Yiluo-pHoton/CISS-ROV2017/Photos/WechatIMG2279.jpeg

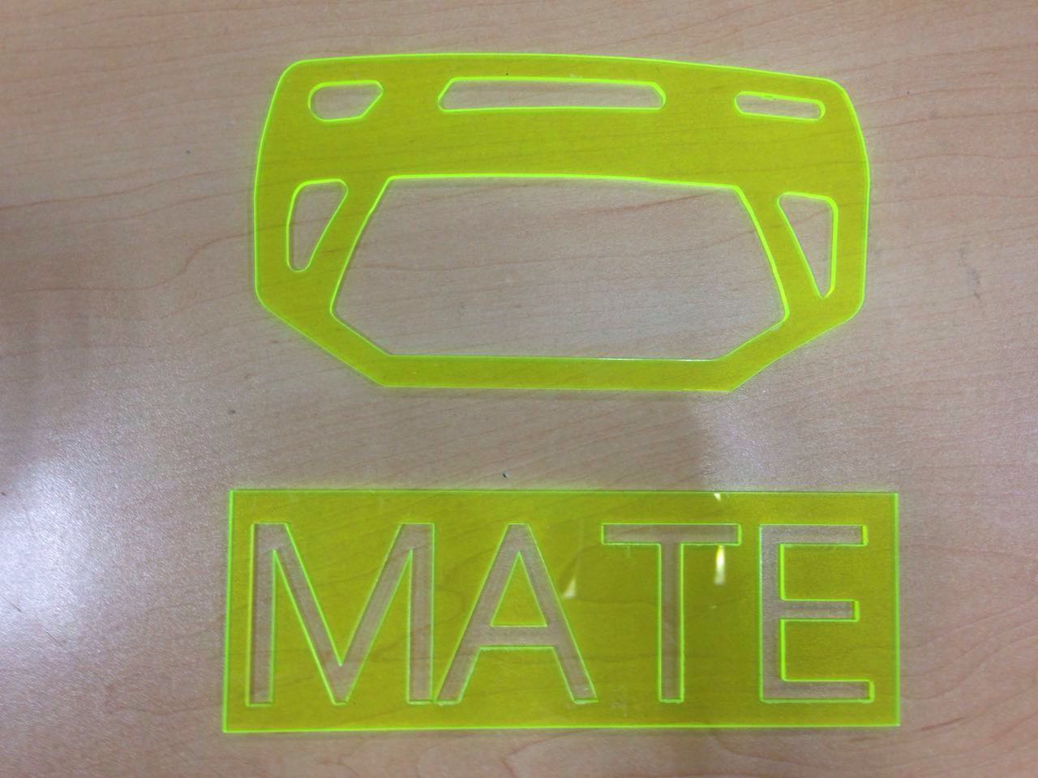
Photos/WechatIMG2279.jpeg
