Yiluo-pHoton/CISS-ROV2017/Photos/WechatIMG2266.jpeg

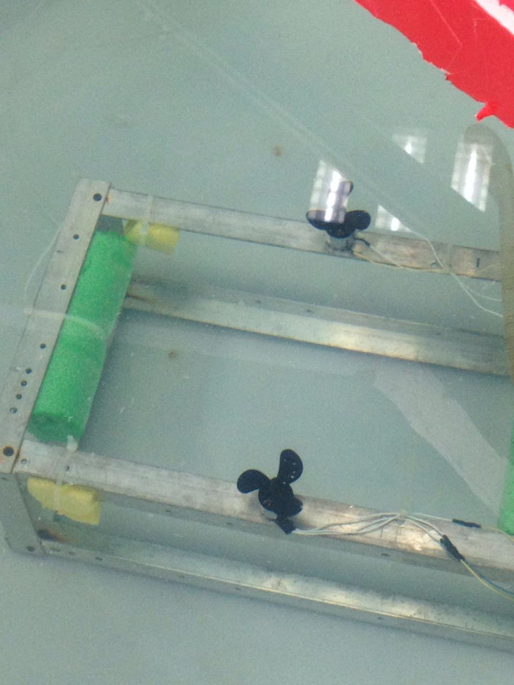
Photos/WechatIMG2266.jpeg
