Yiluo-pHoton/CISS-ROV2017/README.md

Concordia Underwater Robotics for MATE 2017
===================
All files related to the competition issued by the MATE Center are included in the ```Official File``` folder.
Communication between the mission control and the ROV is through the client.py file. However, the most updated file is on the Raspberry Pi and is not included here.

**Team Catalyst**
Danny Kong - Director
Yiluo Li – Director
Andrew Chen – Hardware Engineer, Pilot Joshua Cheng – Chief Engineer
Ryuichi Yanagi – Hardware Engineer Sam Chen – Technician
Joel Klammer – Mentor

**Acknowledgement:**
Joel Klammer
MATE Center
Concordia International School Shanghai
