Yiluo-pHoton/CISS-ROV2017/Docs/Ranger_R18_China_Concordia_Spec_003.pdf

# Catalyst

# Project Wormhole Spec Sheet

Safety features: Fuse, propeller shrouds, rounded corners on frame
Special features: Manipulator with five degrees of motion, multiple cameras, acrylic frame, joystick control, minimal wires in tether, ability to move along 4 axes of motion: forward/back, left/right, up/down, yaw, and 3 angular stabilization axes: zenith/elevation azimuthal, and roll.
Thrusters: 4 main thrusters angled at 45° and 2 up/down motors
Dimensions: 30 cm x 28cm x 25cm
Cameras: 2 front stereo, 1 front main, 1 tether
looking down, 1 on back for third-person
view

# Team Catalyst

Danny Kong - Director
Yiluo Li – Director
Andrew Chen – Hardware Engineer, Pilot Joshua Cheng – Chief Engineer
Ryuichi Yanagi – Hardware Engineer Sam Chen – Technician

Joel Klammer – Mentor

Base of Operations: Concordia International School Shanghai, Shanghai, China
