Yiluo-pHoton/CISS-ROV2017/Official Files/Controller Button Mapping.png

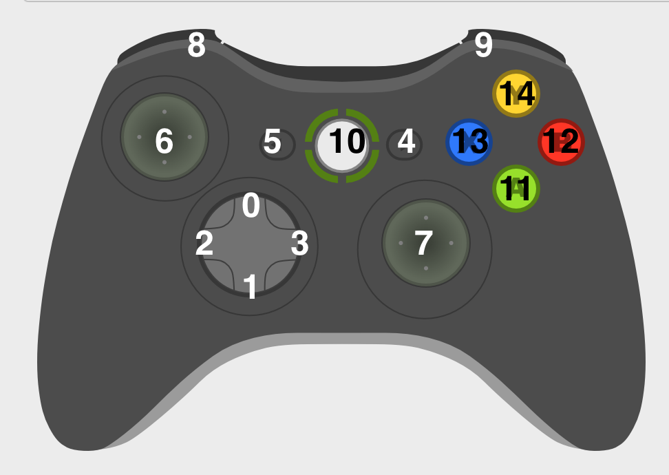
Official Files/Controller Button Mapping.png
