Yiluo-pHoton/CISS-ROV2017/Official Files/Spectrometer Info.png

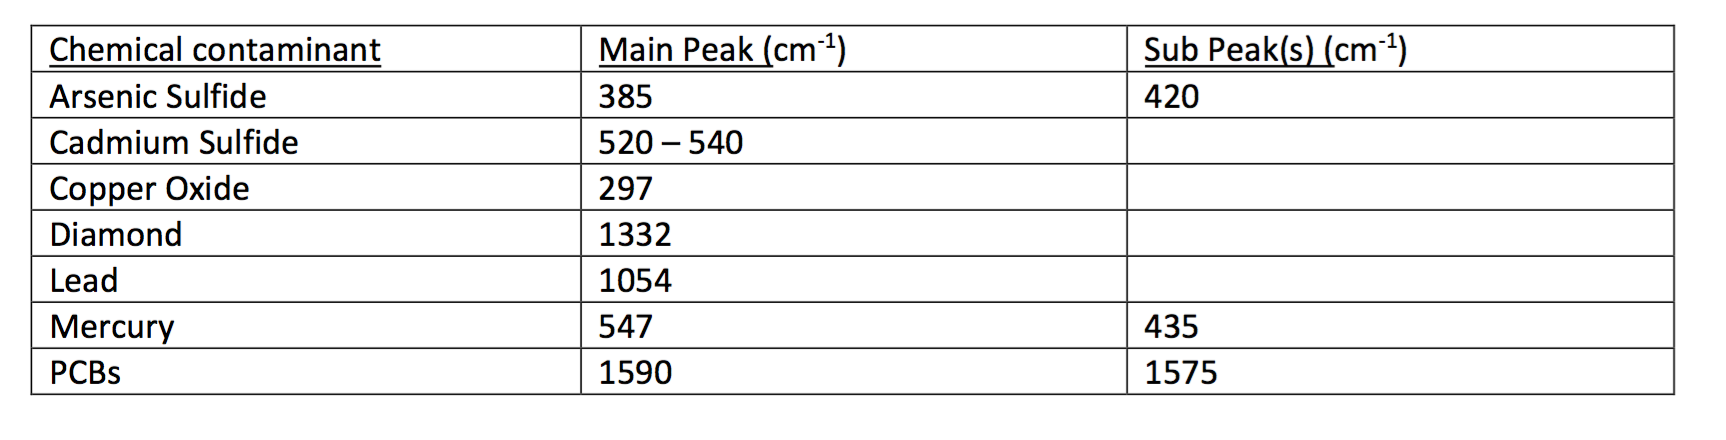
Official Files/Spectrometer Info.png
