Yiluo-pHoton/CISS-ROV2017/Photos/WechatIMG2262.jpeg

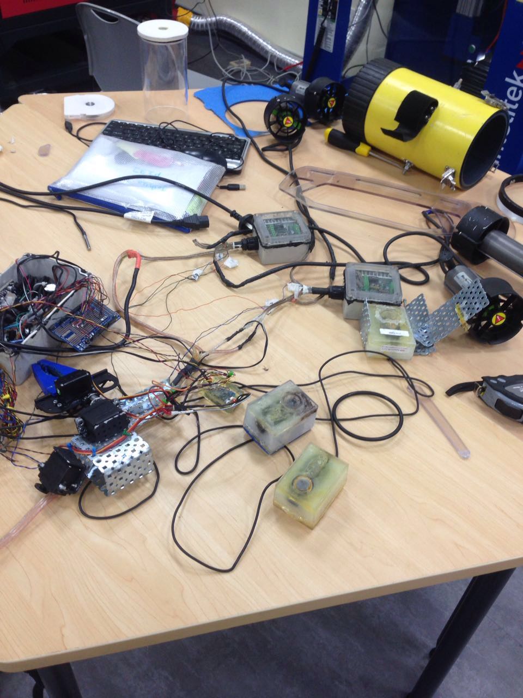
Photos/WechatIMG2262.jpeg
