Yiluo-pHoton/CISS-ROV2017/Photos/WechatIMG2264.jpeg

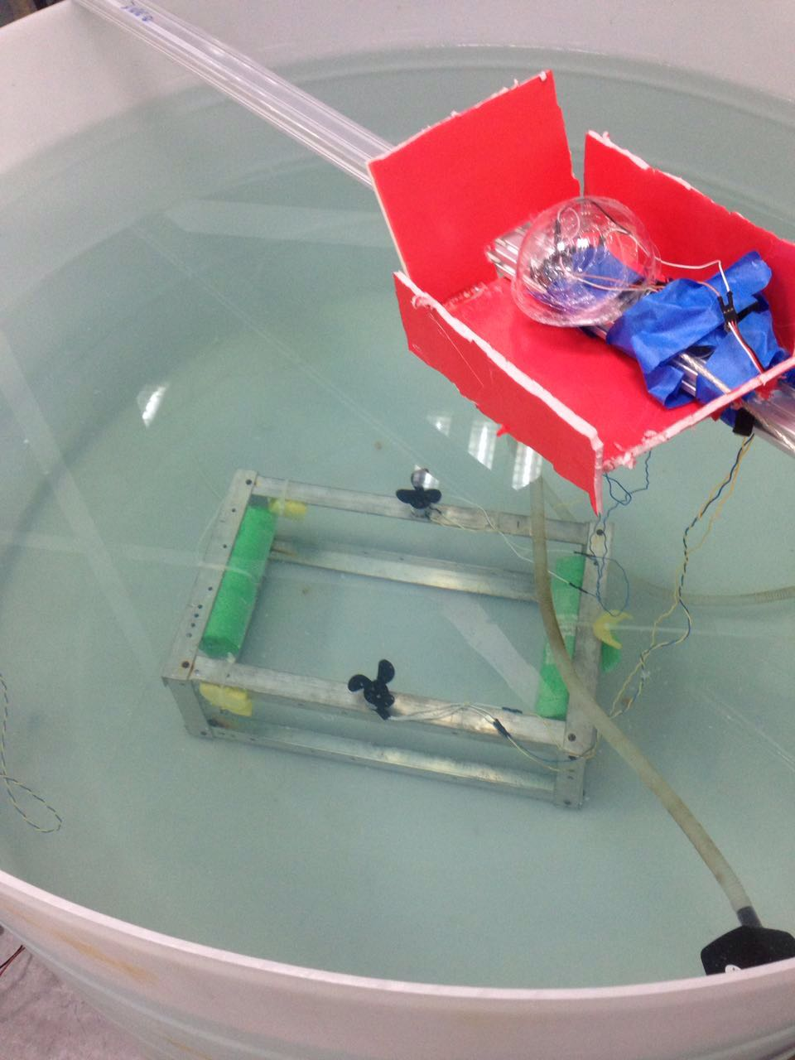
Photos/WechatIMG2264.jpeg
