Yiluo-pHoton/CISS-ROV2017/Photos/WechatIMG2265.jpeg

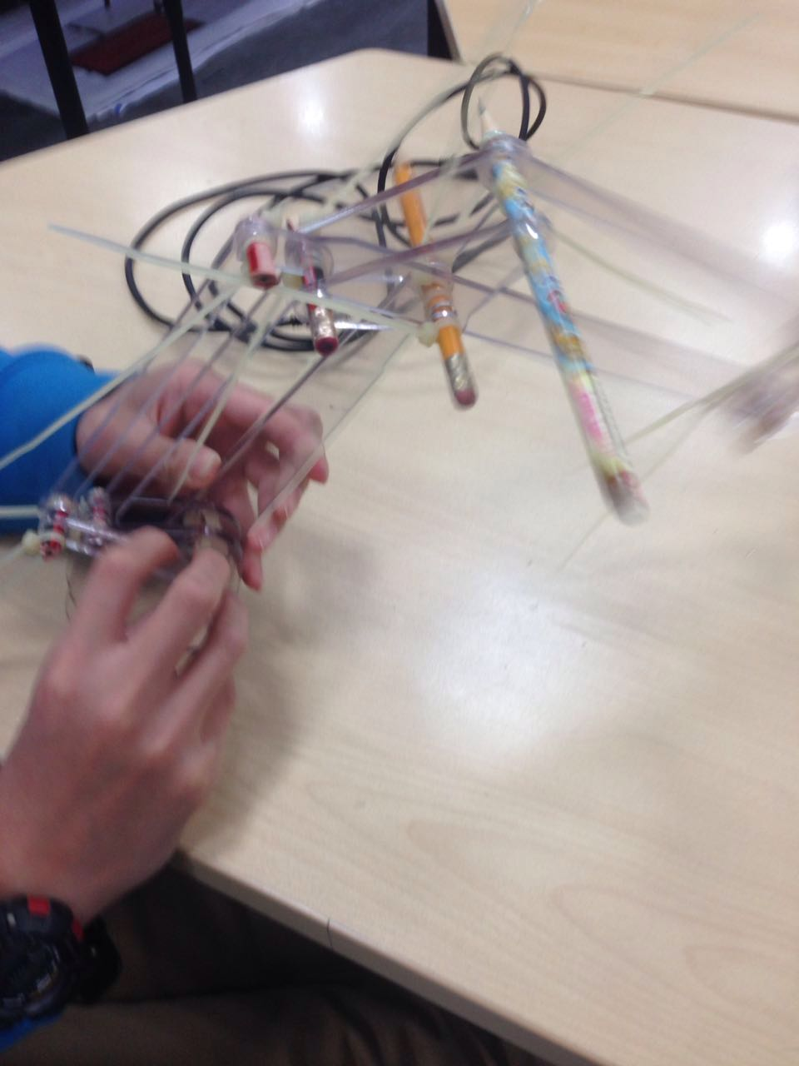
Photos/WechatIMG2265.jpeg
