Yiluo-pHoton/CISS-ROV2017/Photos/WechatIMG2267.jpeg

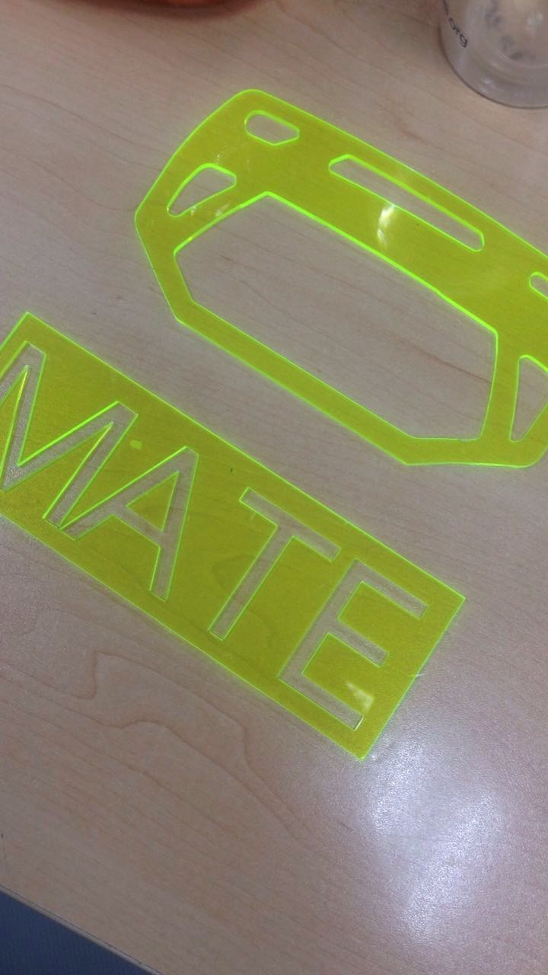
Photos/WechatIMG2267.jpeg
