Yiluo-pHoton/CISS-ROV2017/Testing/SimpleDigitalFirmata/SimpleDigitalFirmata.ino

/*
 * Firmata is a generic protocol for communicating with microcontrollers
 * from software on a host computer. It is intended to work with
 * any host computer software package.
 *
 * To download a host software package, please click on the following link
 * to open the download page in your default browser.
 *
 * http://firmata.org/wiki/Download
 */

/* Supports as many digital inputs and outputs as possible.
 *
 * This example code is in the public domain.
 */
#include <Firmata.h>
#include <Servo.h>

byte previousPIN[TOTAL_PORTS];  // PIN means PORT for input
byte previousPORT[TOTAL_PORTS];
Servo myservo;  // create servo object to control a servo
// twelve servo objects can be created on most boards

int pos = 0;    // variable to store the servo position

void outputPort(byte portNumber, byte portValue)
{
  // only send the data when it changes, otherwise you get too many messages!
  if (previousPIN[portNumber] != portValue) {
    Firmata.sendDigitalPort(portNumber, portValue);
    previousPIN[portNumber] = portValue;
  }
}

void setPinModeCallback(byte pin, int mode) {
  if (IS_PIN_DIGITAL(pin)) {
    pinMode(PIN_TO_DIGITAL(pin), mode);
  }
}

void digitalWriteCallback(byte port, int value)
{
  byte i;
  byte currentPinValue, previousPinValue;

  if (port < TOTAL_PORTS && value != previousPORT[port]) {
    for (i = 0; i < 8; i++) {
      currentPinValue = (byte) value & (1 << i);
      previousPinValue = previousPORT[port] & (1 << i);
      if (currentPinValue != previousPinValue) {
        digitalWrite(i + (port * 8), currentPinValue);
      }
    }
    previousPORT[port] = value;
  }
}

void servoForward()
{
  for (pos = 0; pos <= 180; pos += 1) { // goes from 0 degrees to 180 degrees
    // in steps of 1 degree
    myservo.write(pos);              // tell servo to go to position in variable 'pos'
    delay(15);                       // waits 15ms for the servo to reach the position
  }
}

void servoBackward(){
  for (pos = 180; pos >= 0; pos -= 1) { // goes from 180 degrees to 0 degrees
    myservo.write(pos);              // tell servo to go to position in variable 'pos'
    delay(15);                       // waits 15ms for the servo to reach the position
  }
}
void setup()
{
  Firmata.setFirmwareVersion(FIRMATA_FIRMWARE_MAJOR_VERSION, FIRMATA_FIRMWARE_MINOR_VERSION);
  Firmata.attach(DIGITAL_MESSAGE, digitalWriteCallback);
  Firmata.attach(SET_PIN_MODE, setPinModeCallback);
  Firmata.begin(57600);
}

void loop()
{
  while (Firmata.available()) {
    Firmata.processInput();
  }

  String serialIn;
  serialIn = Serial.readString();
  if(serialIn == "f"){
    servoForward();
  }
  else if(serialIn == "w"){
    servoBackward();
  }
}
